MadhanSaiKrishna/AM-Modulator-Demodulator/README.md

# AM-Modulator-Demodulator
EW2 Project 2: DSB-SC Amplitude Modulator &amp; Demodulator
