MadhanSaiKrishna/AM-Modulator-Demodulator/Report/main.pdf

# Design, Implementation, and Analysis of an AM Modulator and Demodulator

## Electronic Workshop 2 - Project 2

Chamarthy Madhan Sai Krishna
Electronics & Communication Engineering IIIT Hyderabad
chamarthymadhan.k@students.iiit.ac.in 2023102030

Sajiv Singh
Electronics & Communication Engineering IIIT Hyderabad
sajiv.singh@research.iiit.ac.in 2023112003

Abstract—The project focuses on the design, implementation and analysis of a Double Sideband Suppressed Carrier (DSB-SC) Amplitude Modulation(AM) modulator and demodulator circuit prototype.
The main goal was to modulate the carrier signal, generated by the Local Oscillator (LO), using the modulating signal from the DSO, and to successfully recover the original signal. Through practical implementation, the project demonstrates the fundamental concepts of Communication Theory. The circuit helps in understanding how information can be encoded and transmitted over a carrier signal using AM techniques.
I. TO-DO:
- Improvise the photos of the spectrums - conventional AM and DSB-SC AM
- add github link, youtube video link
- add calculations, simulations, outputs,

II. INTRODUCTION
A. Background of Amplitude Modulation
Amplitude Modulation (AM) is a modulation technique where the amplitude (signal strength) of a carrier wave is varied in proportion to the message signal (e.g., audio). It’s commonly used in electronic communication for transmitting messages via radio waves. In AM, carrier signal’s amplitude, A(t), changes according to the message signal. This message signal defines the envelope of the transmitted waveform. In the frequency domain, AM produces a signal with power concentrated at the carrier frequency and two adjacent sidebands. Types of Amplitude Modulation:
- Double-Sideband Amplitude Modulation (DSB-AM): The standard AM method generates sidebands on both sides of the carrier frequency. These sidebands contain the frequency components of the modulating signal and are symmetrically placed around the carrier frequency.
- Single-Sideband Modulation (SSB): Uses bandpass filters to eliminate one sideband and possibly the carrier, improving power efficiency and bandwidth utilization.
- Quadrature Amplitude Modulation (QAM): A more complex form of Amplitude modulation is often used with digital data to enable more efficient use of bandwidth.
- Double-Sideband Suppressed Carrier (DSB-SC): This technique removes the carrier signal, transmitting only the upper and lower sidebands. It improves power efficiency but requires coherent detection at the receiver.
- Vestigial Sideband Modulation (VSB): VSB retains part of one sideband while suppressing the rest of the unwanted sideband. This method helps reduce the bandwidth required for transmission, offering a more efficient use of spectrum compared to standard AM, while still allowing for accurate signal recovery at the receiver.
- Pulse Amplitude Modulation (PAM): PAM varies the amplitude of pulses rather than a continuous wave. It is used in digital communication systems as an intermediate step before converting signals to binary formats.
B. Objectives

Following are the primary objectives of this project:
1) To design and implement a Double Sideband Suppressed Carrier (DSB-SC) Amplitude Modulation (AM) modulator circuit capable of encoding a modulating signal onto a carrier signal generated by a Local Oscillator (LO).
2) To design and implement a corresponding demodulator circuit that can successfully recover the original modulating signal from the received DSB-SC AM signal.
3) To analyze the performance of the implemented modulator and demodulator circuits through practical experimentation, demonstrating the principles of amplitude modulation in communication systems.

III. THEORETICAL BACKGROUND OF AM

Modulation: In conventional AM, we add a large carrier component to a DSB-SC signal, so that the passband transmitted signal is of the form:

uAM(t) = Am(t) cos(2πfct) + Ac cos(2πfct)

Taking the Fourier transform, we have

UAM(f) = A
2

(M(f − fc) + M(f + fc)) +


Fig. 1. Spectrum of Conventional AM


Fig. 2. Spectrum of DSB-SC AM

Ac
2

(δ(f − fc) + δ(f + fc))

which means that, in addition to the USB and LSB due to the message modulation, we also have impulses at ±fc due to the unmodulated carrier.
The key concept behind conventional AM is that, by making Ac large enough, the message can be demodulated using a simple envelope detector. Large Ac corresponds to expending transmitter power on sending an unmodulated carrier which carries no message information, in order to simplify the receiver. This tradeoff makes sense in a broadcast context, where one powerful transmitter may be sending information to a large number of low-cost receivers, and is the design approach that has been adopted for broadcast AM radio. The key issue with conventional AM is its inefficiency in terms of power utilization. This led to the development of DSB-SC modulation which addresses these issues by suppressing the carrier and improving the power efficiency.

uDSB(t) = Am(t) cos(2πfct)

Taking Fourier transforms, we have

UDSB(f) = A
2

(M(f − fc) + M(f + fc))

Demodulation:

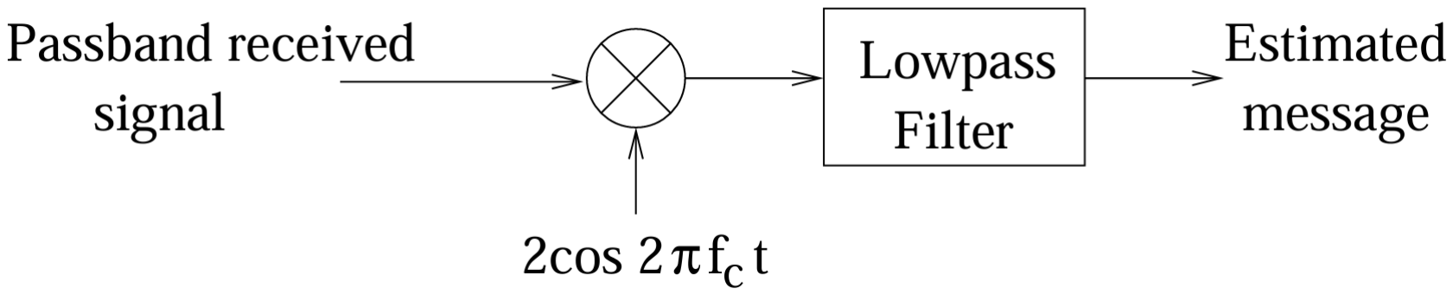
[picture p29: figure]

Fig. 3. Coherent Demodulation of AM

Multiply the received signal with the cosine of the carrier, and pass it through a low-pass filter. Ignoring noise, the received signal is given by

yp(t) = Am(t) cos(2πfct + θr)

where θr is the phase of the received carrier relative to the local copy of the carrier produced by the receiver’s local oscillator (LO), and A is the received amplitude, taking into account the propagation channel from the transmitter to the receiver. In order for this demodulator to work well, we must have θr as close to zero as possible; that is, the carrier produced by the LO must be coherent with the received carrier. The effect of phase mismatch:

2yp(t) cos(2πfct) = Am(t) cos(2πfct + θr) cos(2πfct)

= Am(t) cos θr + Am(t) cos(4πfct + θr)

We recognize the second term on the right-hand side as being a passband signal at 2fc (since it is a baseband message multiplied by a carrier whose frequency exceeds the message bandwidth). It is therefore rejected by the low-pass filter. The first term is a baseband signal proportional to the message, which appears unchanged at the output of the LPF (except possibly for scaling), as long as the LPF response has been designed to be flat over the message bandwidth. The output of the demodulator is therefore given by

mˆ (t) = Am(t) cos θr

The demodulator output is proportional to the message, which is what we want, but the proportionality constant varies with the phase of the received carrier relative to the LO. In particular, the signal gets significantly attenuated as the phase mismatch increases, and gets completely wiped out for θr =

π
2
Note that, if the carrier frequency of the LO is not synchronized with that of the received carrier (say with frequency offset ∆f), then θr(t) = 2π∆f t + ϕ is a time-varying phase that takes all values in [0, 2π), which leads to time-varying signal degradation in amplitude, as well as unwanted sign changes. Thus, for coherent demodulation to be successful, we must drive ∆f to zero, and make ϕ as small as possible; that is, we must synchronize to the received carrier.

IV. CIRCUIT DESIGN & IMPLEMENTATION

A. Local Oscillator
Ref. from last year AEC project


Fig. 4. Full Circuit


Fig. 5. Simulation output of the Oscillator

B. Modulator
Ref. from last year mixer
C. Demodulator
mixer + LPF
V. EXPERIMENTAL SETUP & METHODOLOGY

VI. RESULTS & PERFORMANCE METRICS
1) Detectability: , i.e., the quality of the demodulated signal for a given amount of channel attenuation and receiver noise.
2) Bandwidth efficiency: , i.e., the bandwidth occupied by the modulated carrier for a given information rate in the baseband signal. This aspect plays a critical role in today’s systems because the available spectrum is limited.

VII. CONCLUSION
The project successfully demonstrated the design, implementation, and analysis of a Double Sideband Suppressed Carrier (DSB-SC) Amplitude Modulation (AM) modulator and demodulator circuit prototype. The experimental results confirmed the effectiveness of the DSB-SC technique in modulating and demodulating signals, showcasing its potential for efficient communication systems.The project also highlighted the importance of coherent detection and the challenges associated with phase synchronization in demodulation.
Github: Repository Link (https://github.com/MadhanSaiKrishna/AM-Modulator-Demodulator)
Youtube: Video Link

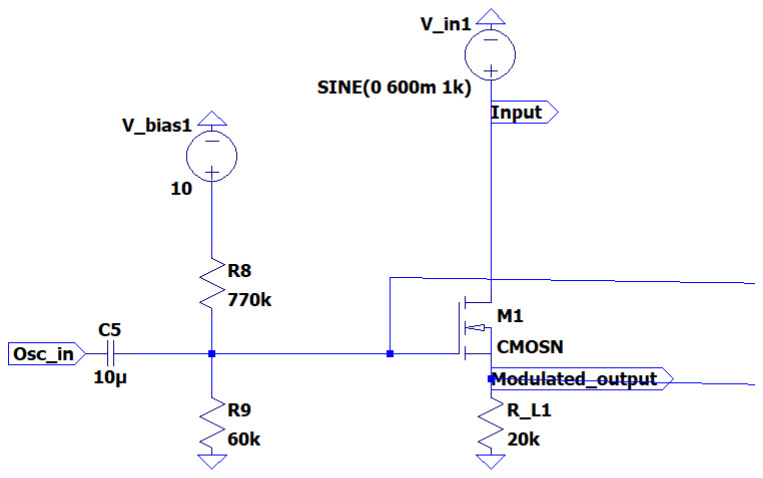
[picture p30: figure]

Fig. 6. Circuit diagram of the modulator

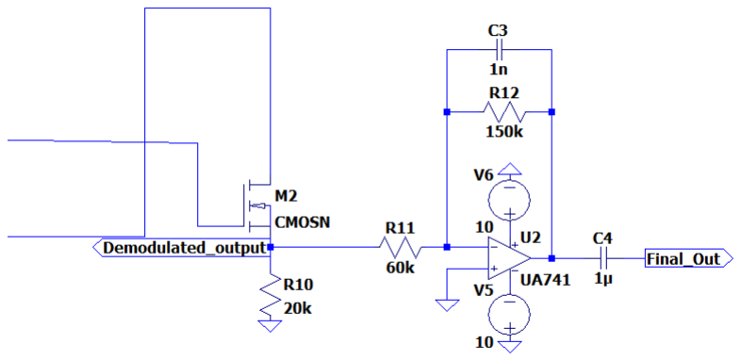
[picture p31: figure]

Fig. 7. Circuit diagram of the demodulator


Fig. 8. FFT of the output of the oscillator (Simulation)

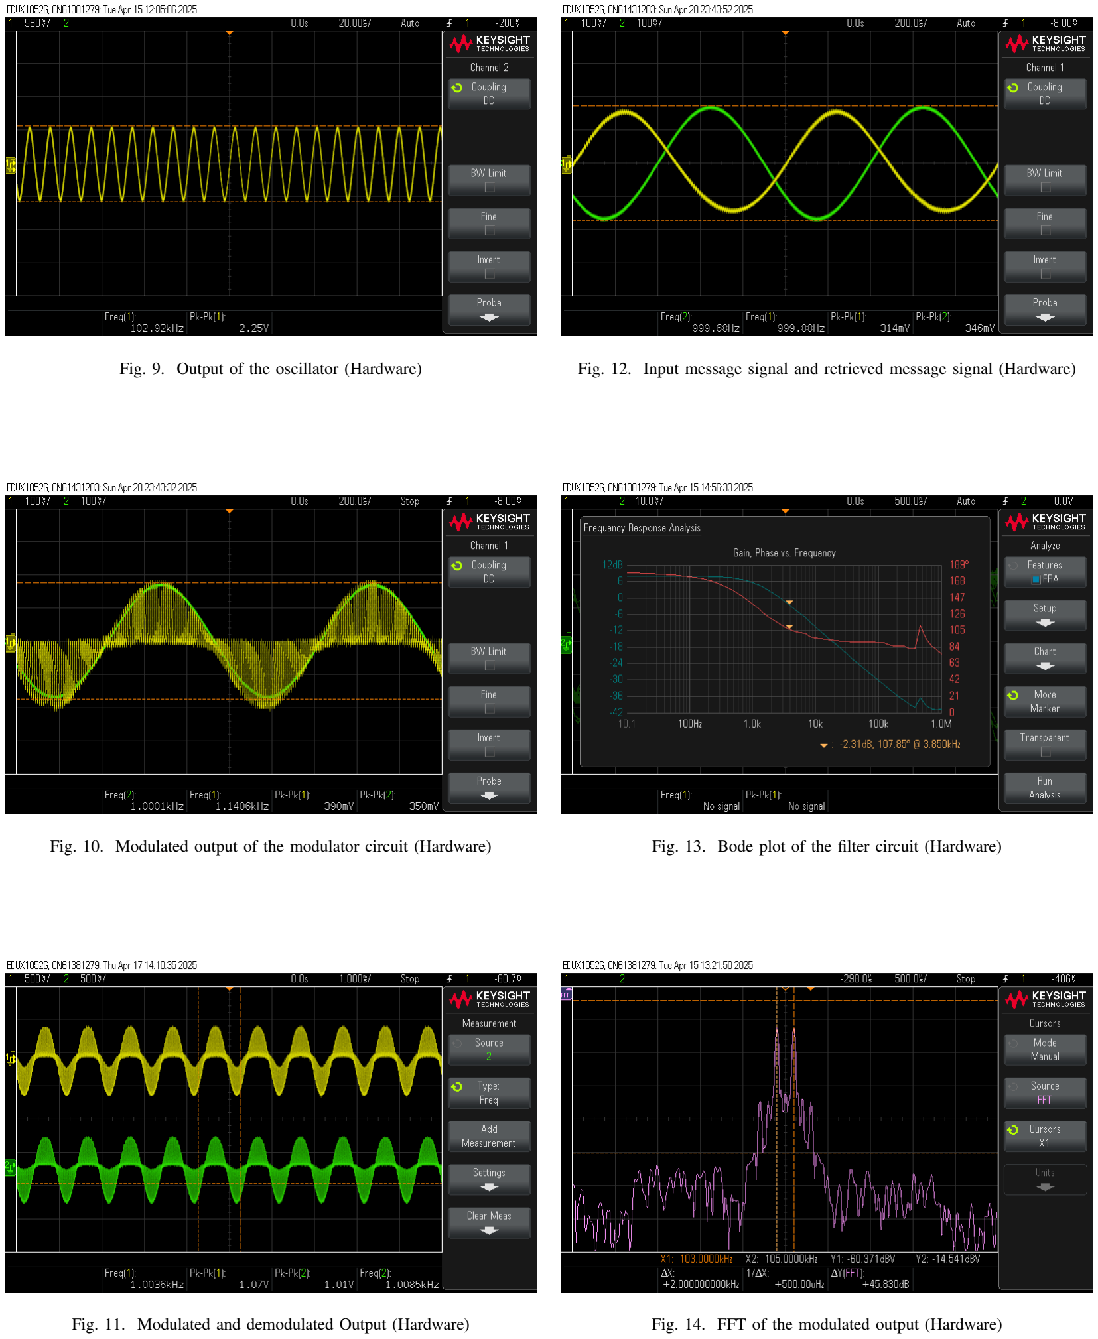
[picture p32: page 4]

Fig. 9. Output of the oscillator (Hardware)

Fig. 10. Modulated output of the modulator circuit (Hardware)

Fig. 11. Modulated and demodulated Output (Hardware)

Fig. 12. Input message signal and retrieved message signal (Hardware)

Fig. 13. Bode plot of the filter circuit (Hardware)

Fig. 14. FFT of the modulated output (Hardware)

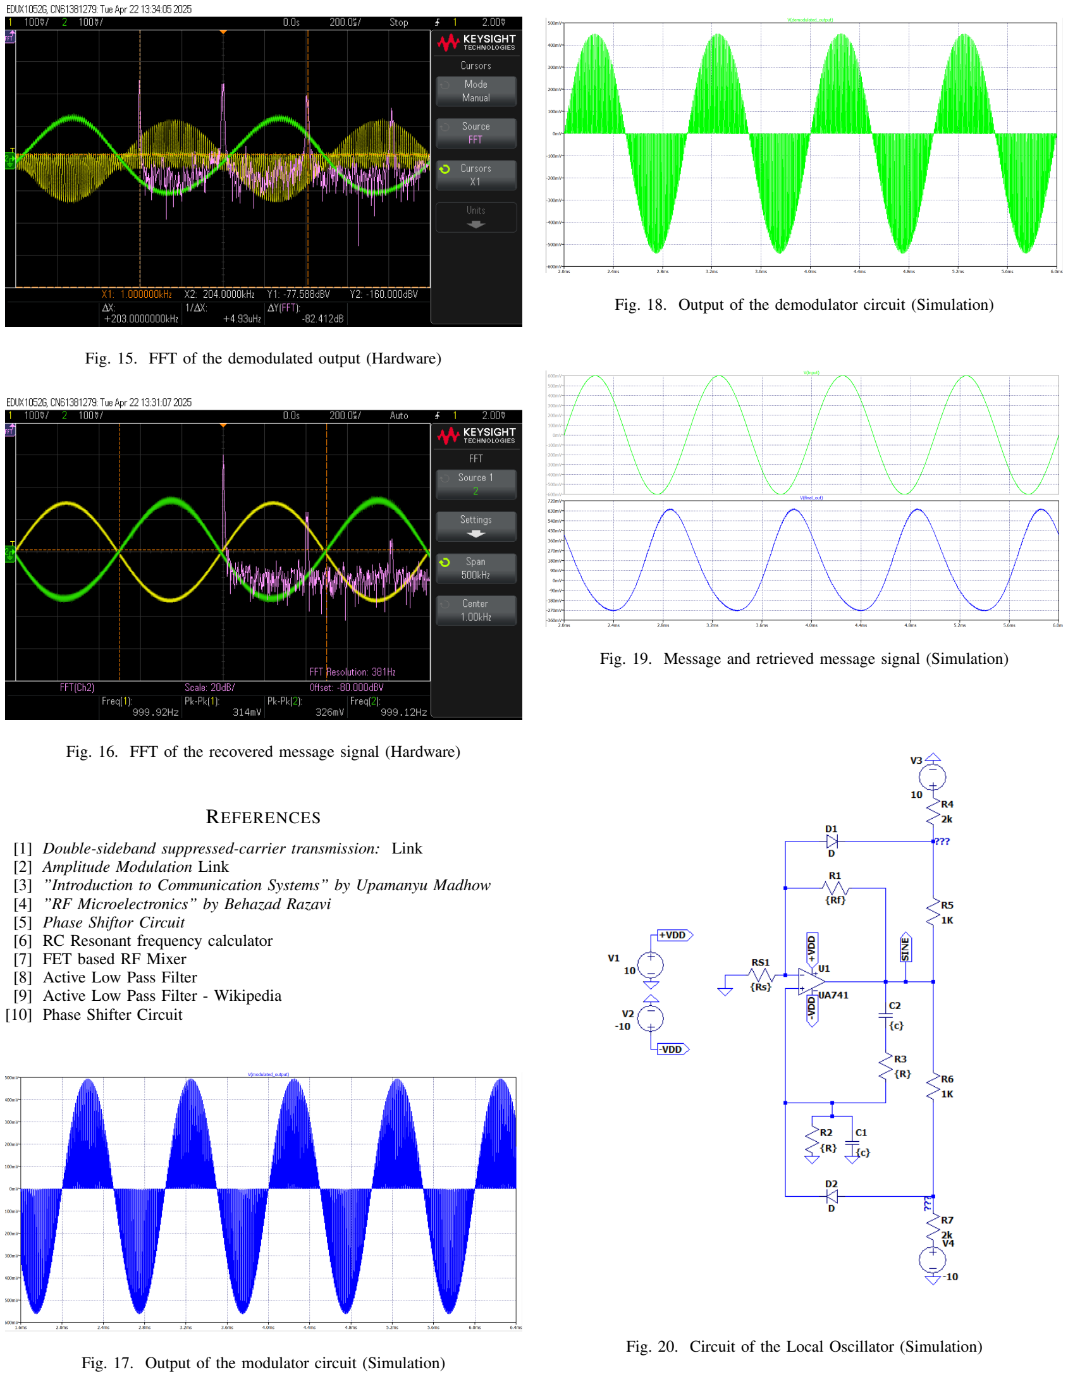
[picture p33: page 5]

Fig. 15. FFT of the demodulated output (Hardware)

Fig. 16. FFT of the recovered message signal (Hardware)

REFERENCES

[1] Double-sideband suppressed-carrier transmission: Link (https://en.wikipedia.org/wiki/Double-sideband_suppressed-carrier_transmission)
[2] Amplitude Modulation Link (https://en.wikipedia.org/wiki/Amplitude_modulation)
[3] ”Introduction to Communication Systems” by Upamanyu Madhow
[4] ”RF Microelectronics” by Behazad Razavi
[5] Phase Shiftor Circuit (https://vesit.ves.ac.in/RC_phase_shift/theory)
[6] RC Resonant frequency calculator (https://www.omnicalculator.com/physics/rc-circuit)
[7] FET based RF Mixer (https://www.electronics-notes.com/articles/radio/rf-mixer/fet-rf-mixer.php)
[8] Active Low Pass Filter (https://www.electronics-tutorials.ws/filter/filter_5.html)
[9] Active Low Pass Filter - Wikipedia (https://en.wikipedia.org/wiki/Low-pass_filter)
[10] Phase Shifter Circuit (https://wiraelectrical.com/phase-shifter-formula-and-operation/)

Fig. 17. Output of the modulator circuit (Simulation)

Fig. 18. Output of the demodulator circuit (Simulation)

Fig. 19. Message and retrieved message signal (Simulation)

Fig. 20. Circuit of the Local Oscillator (Simulation)

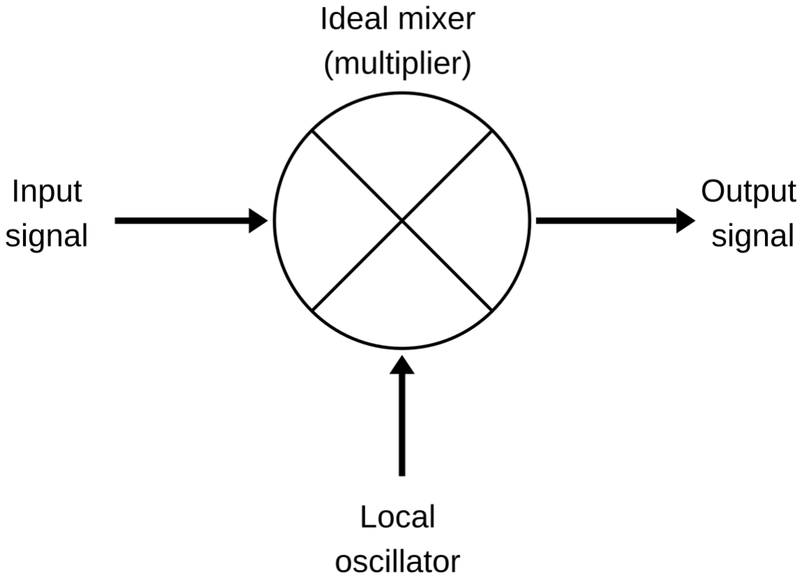
[picture p34: figure]

Fig. 21. Mixer
