MadhanSaiKrishna/AM-Modulator-Demodulator/DSO Results/15th April/scope_1.png

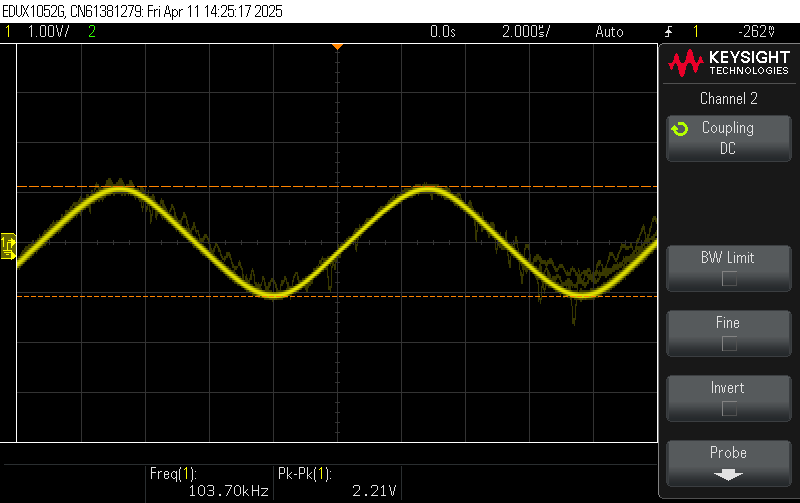
DSO Results/15th April/scope_1.png
