MadhanSaiKrishna/AM-Modulator-Demodulator/DSO Results/15th April/scope_3.png

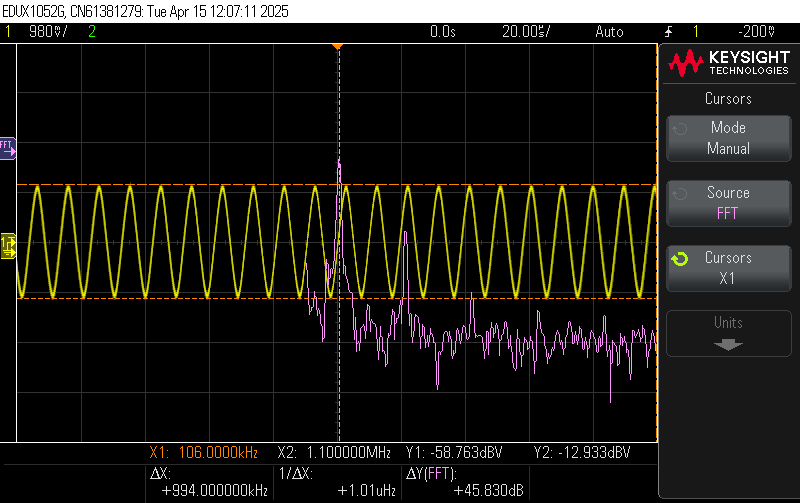
DSO Results/15th April/scope_3.png
