MadhanSaiKrishna/AM-Modulator-Demodulator/DSO Results/15th April/scope_4.png

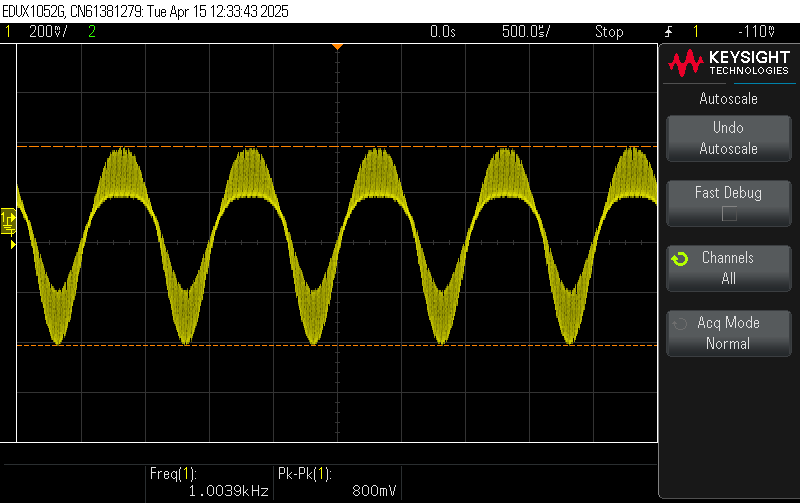
DSO Results/15th April/scope_4.png
