MadhanSaiKrishna/AM-Modulator-Demodulator/DSO Results/15th April/scope_5.png

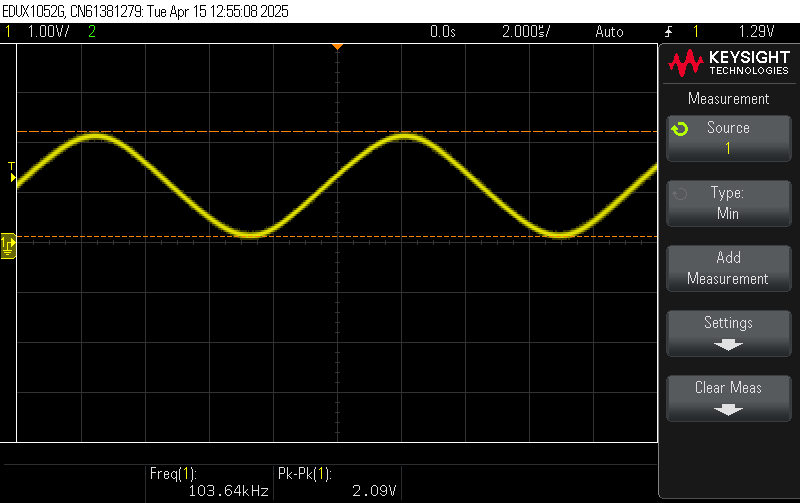
DSO Results/15th April/scope_5.png
