MadhanSaiKrishna/AM-Modulator-Demodulator/DSO Results/15th April/scope_6.png

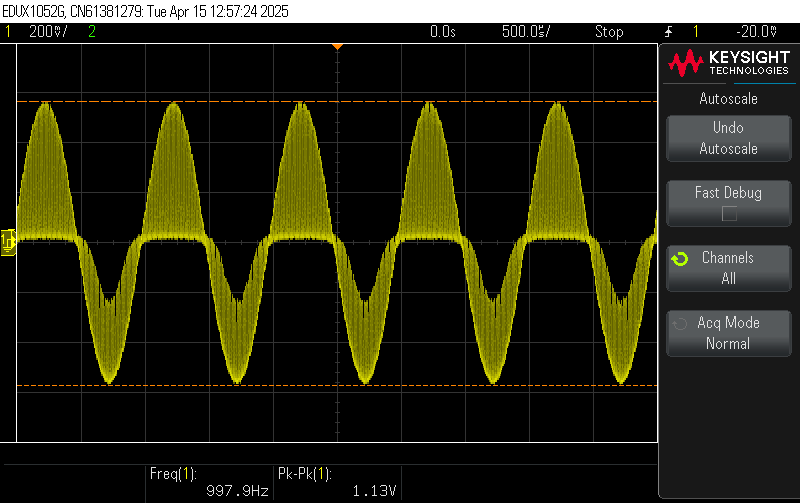
DSO Results/15th April/scope_6.png
