MadhanSaiKrishna/AM-Modulator-Demodulator/DSO Results/15th April/scope_7.png

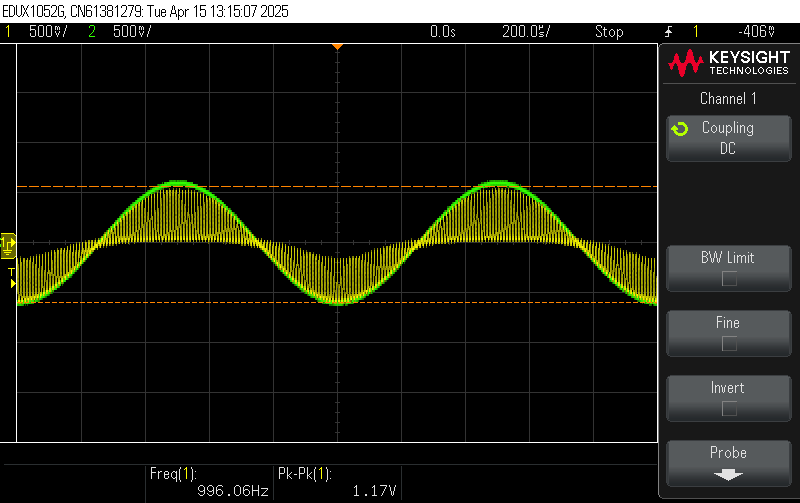
DSO Results/15th April/scope_7.png
