MadhanSaiKrishna/AM-Modulator-Demodulator/DSO Results/15th April/scope_8.png

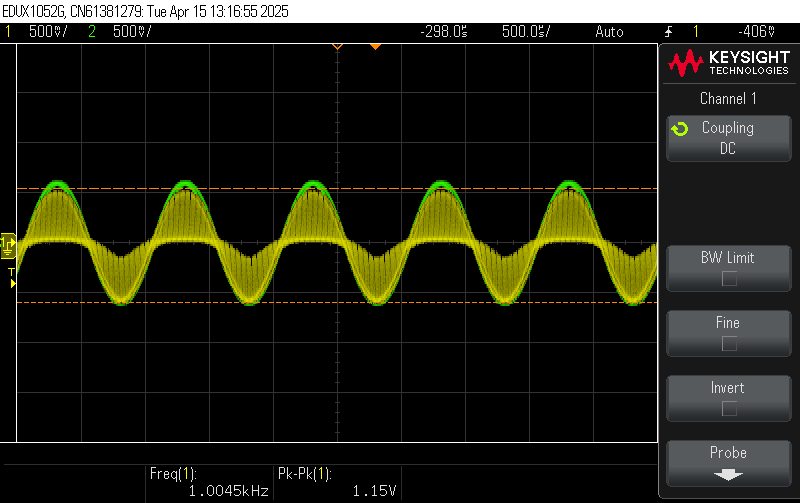
DSO Results/15th April/scope_8.png
