MadhanSaiKrishna/AM-Modulator-Demodulator/DSO Results/15th April/scope_9.png

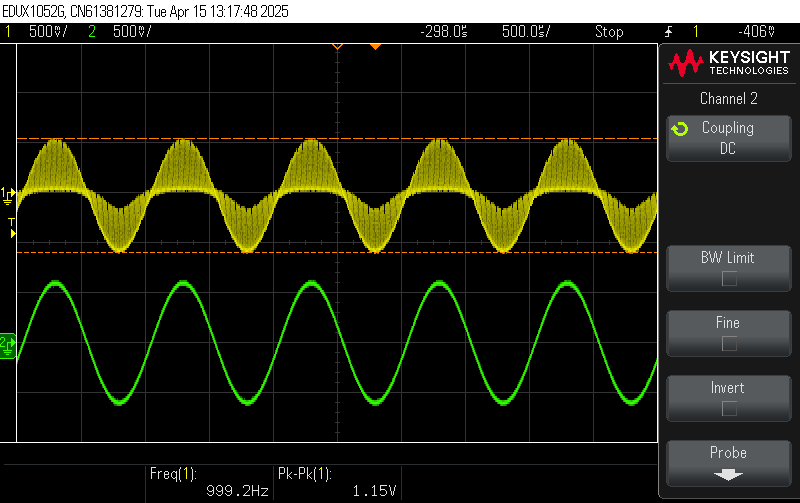
DSO Results/15th April/scope_9.png
