MadhanSaiKrishna/AM-Modulator-Demodulator/DSO Results/15th April/scope_11.png

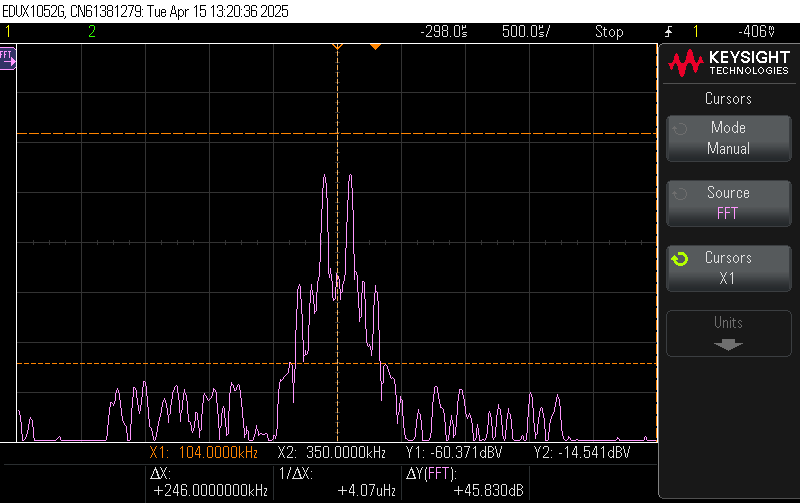
DSO Results/15th April/scope_11.png
