MadhanSaiKrishna/AM-Modulator-Demodulator/DSO Results/17th April/scope_16.png

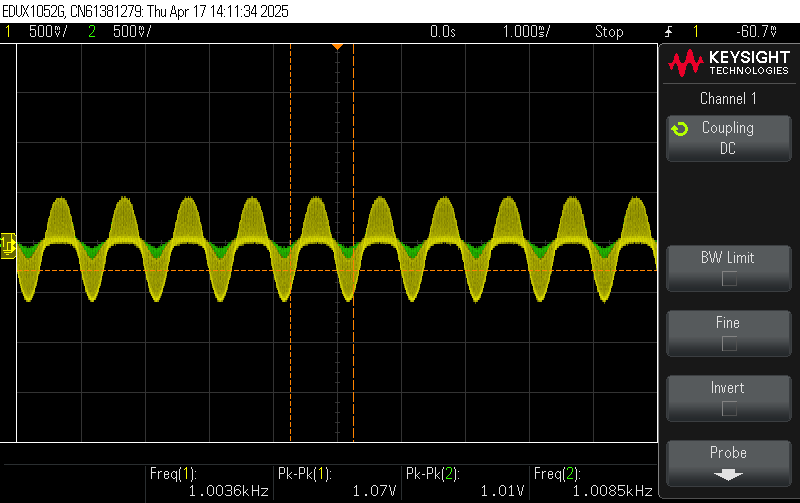
DSO Results/17th April/scope_16.png
