MadhanSaiKrishna/AM-Modulator-Demodulator/DSO Results/17th April/scope_17.png

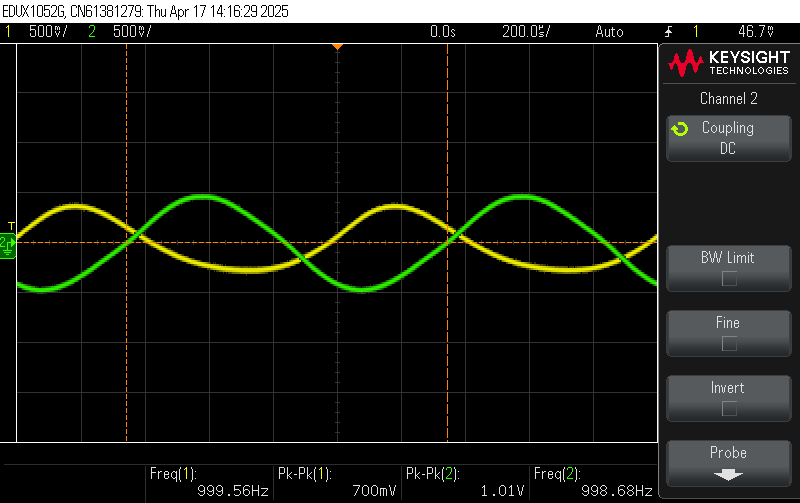
DSO Results/17th April/scope_17.png
