MadhanSaiKrishna/AM-Modulator-Demodulator/DSO Results/17th April/scope_18.png

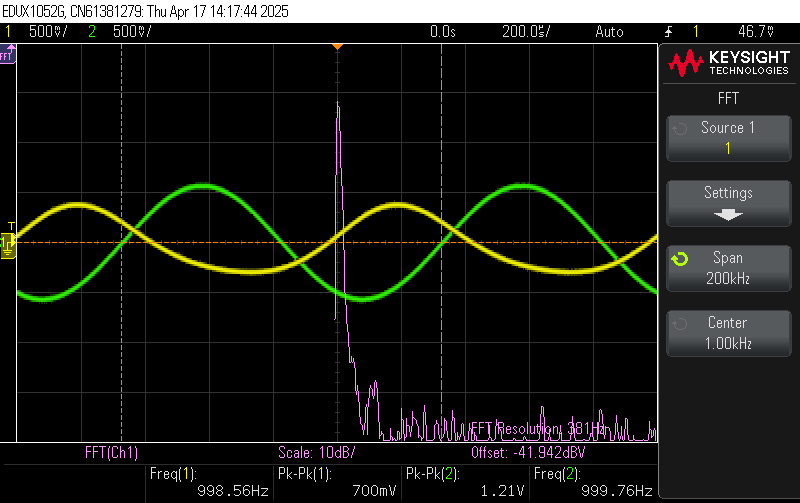
DSO Results/17th April/scope_18.png
