MadhanSaiKrishna/AM-Modulator-Demodulator/DSO Results/17th April/scope_19.png

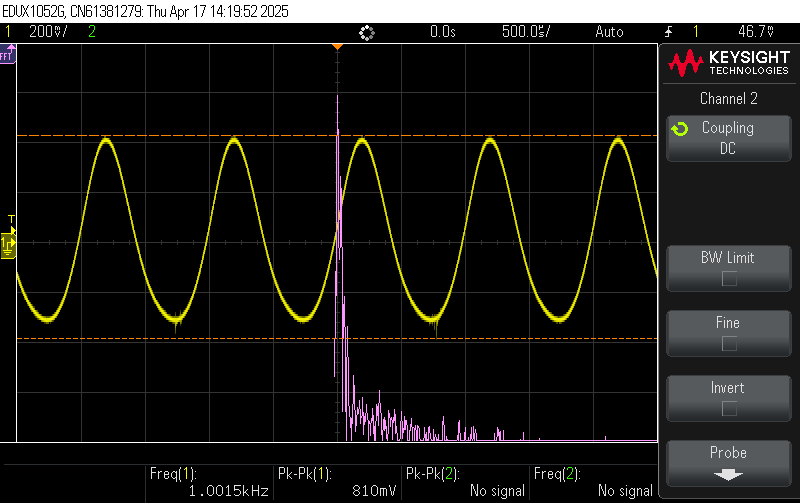
DSO Results/17th April/scope_19.png
