MadhanSaiKrishna/AM-Modulator-Demodulator/DSO Results/17th April/scope_20.png

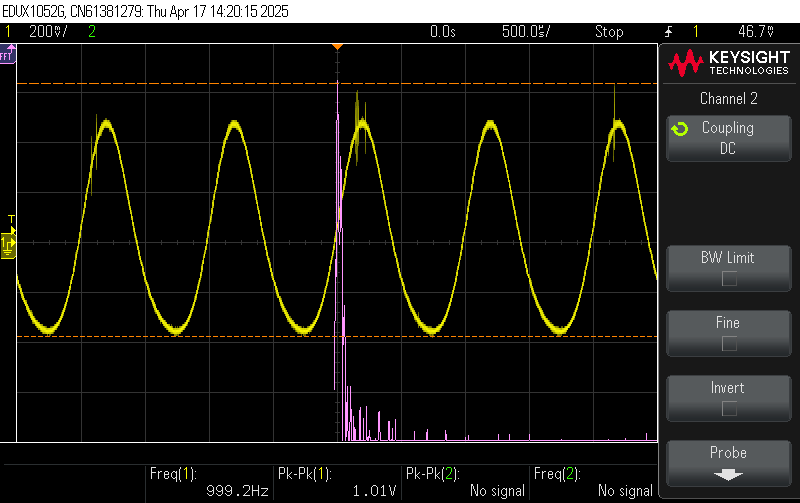
DSO Results/17th April/scope_20.png
