MadhanSaiKrishna/AM-Modulator-Demodulator/DSO Results/20th April/scope_21.png

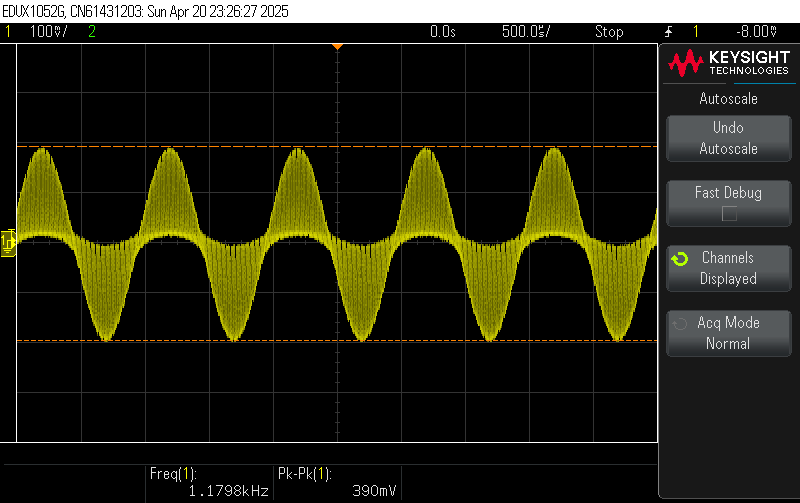
DSO Results/20th April/scope_21.png
