MadhanSaiKrishna/AM-Modulator-Demodulator/DSO Results/20th April/scope_22.png

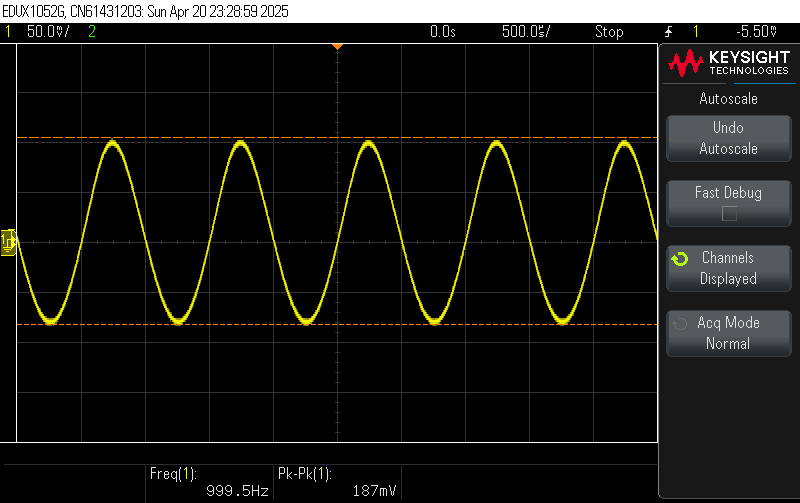
DSO Results/20th April/scope_22.png
