MadhanSaiKrishna/AM-Modulator-Demodulator/DSO Results/20th April/scope_23.png

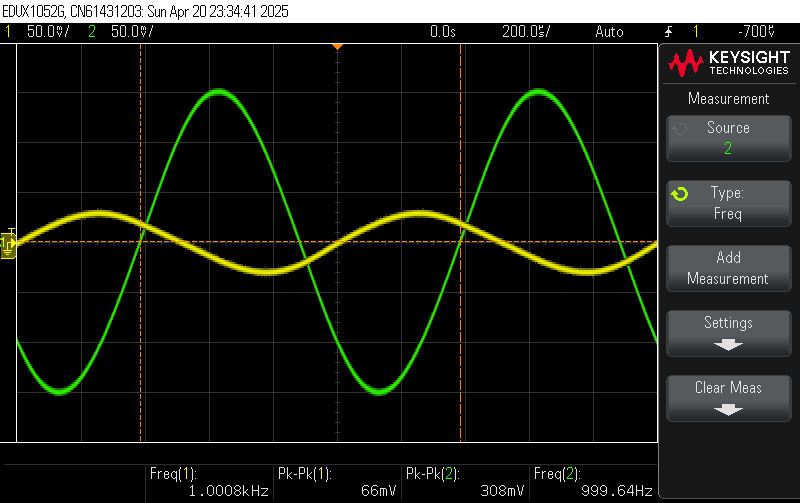
DSO Results/20th April/scope_23.png
