MadhanSaiKrishna/AM-Modulator-Demodulator/DSO Results/20th April/scope_24.png

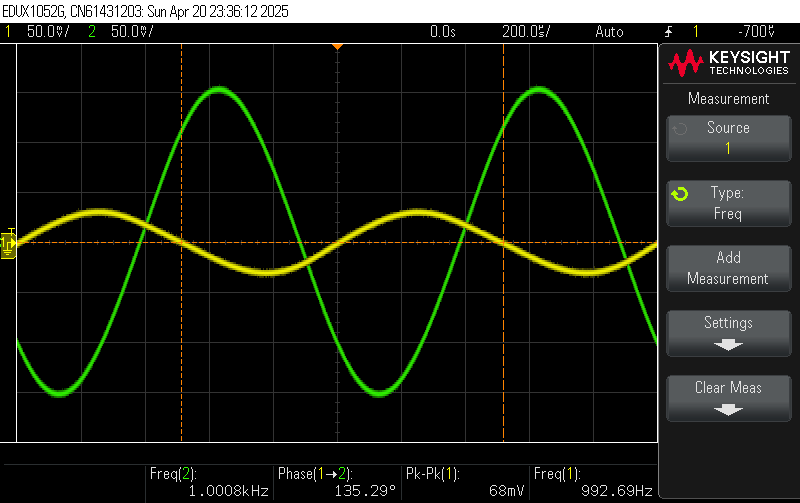
DSO Results/20th April/scope_24.png
