MadhanSaiKrishna/AM-Modulator-Demodulator/DSO Results/20th April/scope_26.png

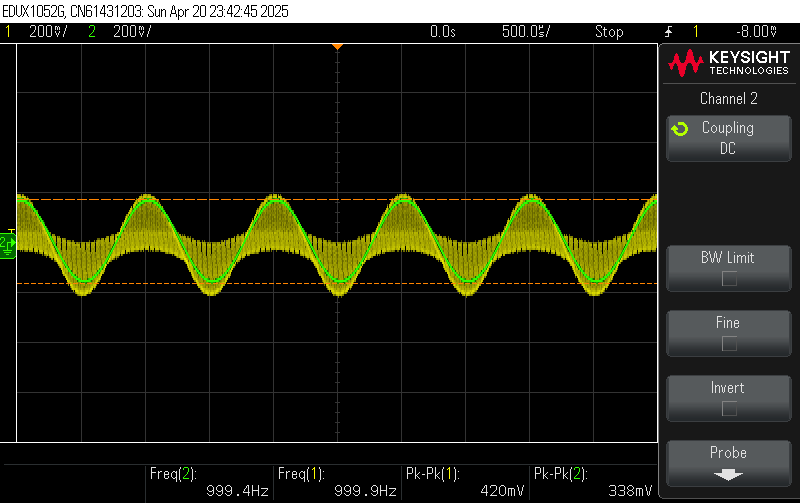
DSO Results/20th April/scope_26.png
