MadhanSaiKrishna/AM-Modulator-Demodulator/DSO Results/20th April/scope_30.png

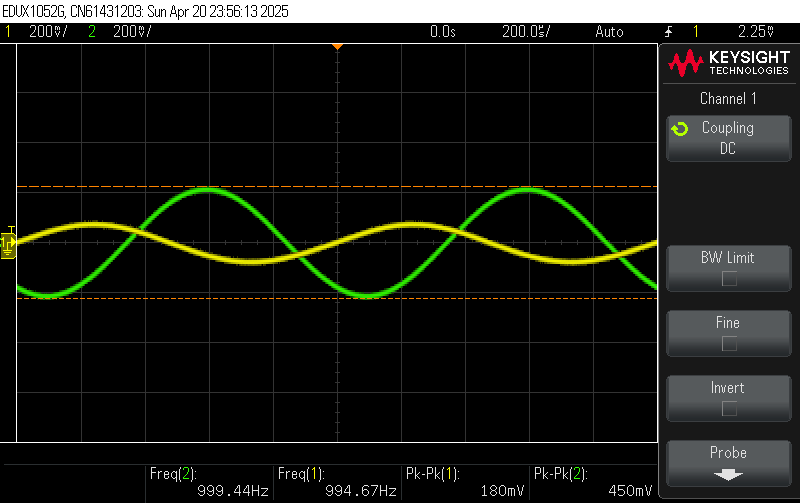
DSO Results/20th April/scope_30.png
