MadhanSaiKrishna/AM-Modulator-Demodulator/DSO Results/20th April/scope_31.png

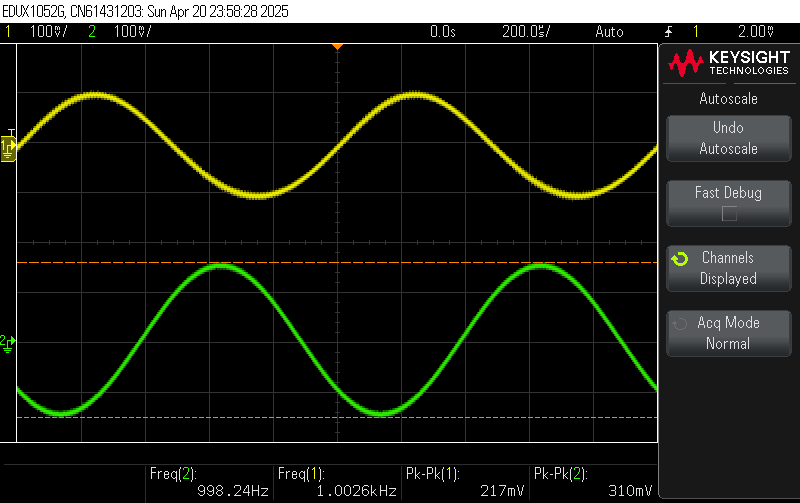
DSO Results/20th April/scope_31.png
