MadhanSaiKrishna/AM-Modulator-Demodulator/DSO Results/20th April/scope_32.png

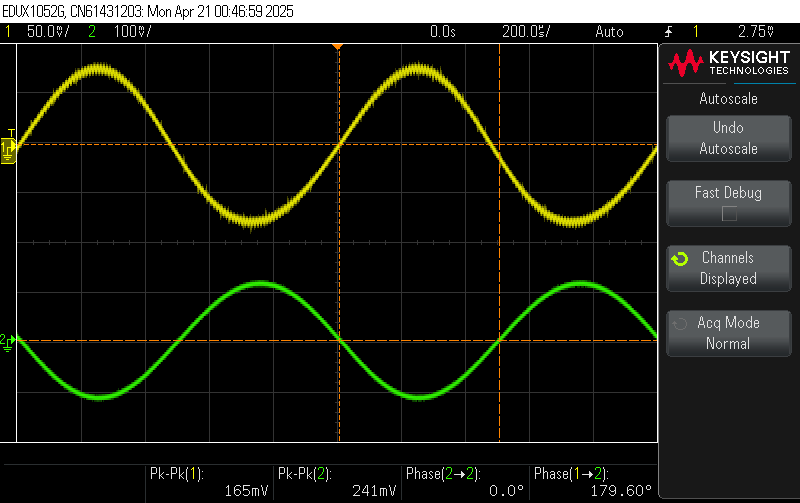
DSO Results/20th April/scope_32.png
