MadhanSaiKrishna/AM-Modulator-Demodulator/DSO Results/22nd April/scope_36.png

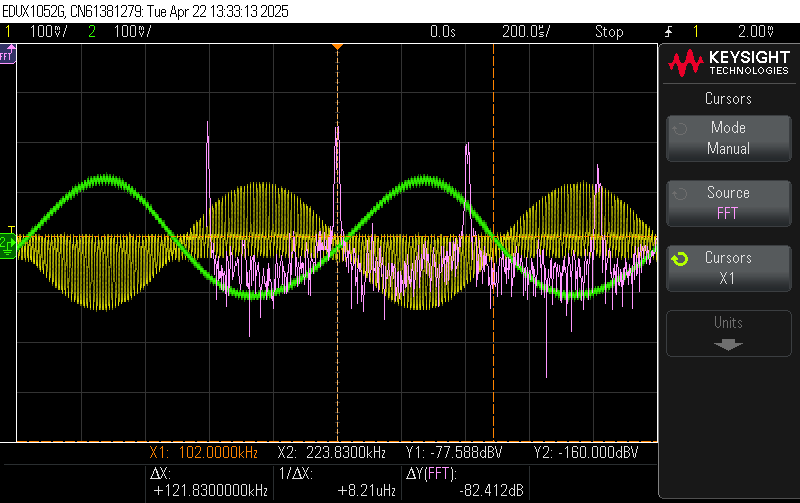
DSO Results/22nd April/scope_36.png
