MadhanSaiKrishna/AM-Modulator-Demodulator/DSO Results/25th March/scope_0.png

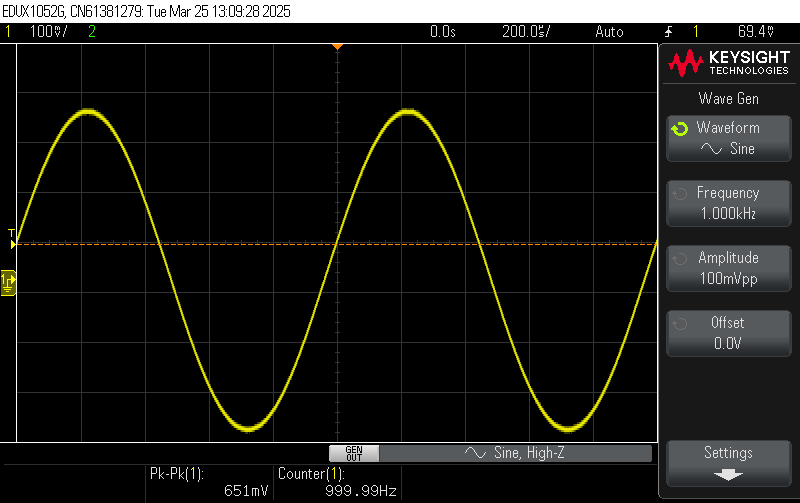
DSO Results/25th March/scope_0.png
