MadhanSaiKrishna/AM-Modulator-Demodulator/DSO Results/25th March/scope_1.png

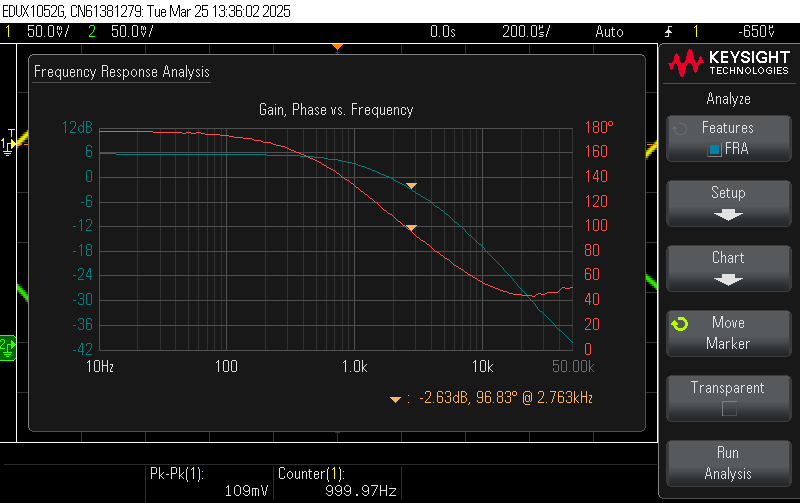
DSO Results/25th March/scope_1.png
