MadhanSaiKrishna/AM-Modulator-Demodulator/DSO Results/25th March/scope_2.png

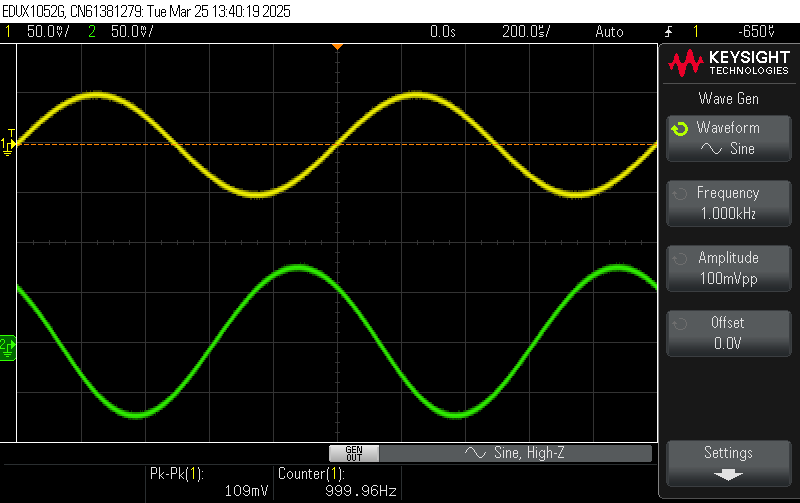
DSO Results/25th March/scope_2.png
