MadhanSaiKrishna/AM-Modulator-Demodulator/Updated_circuit.asc

C1: cap; {c}
C2: cap; {c}
C3: cap; 1n
C4: cap; 1µ
C5: cap; 10µ
D1: diode
D2: diode
M1: nmos4; CMOSN; l={2*LAMBDA} w={width_N} ad={5*width_ N*LAMBDA} as={5*width_ N*LAMBDA} pd={10*LAMBDA+2*width_N} ps={10*LAMBDA+2*width_N}
M2: nmos4; CMOSN; l={2*LAMBDA} w={width_N} ad={5*width_ N*LAMBDA} as={5*width_ N*LAMBDA} pd={10*LAMBDA+2*width_N} ps={10*LAMBDA+2*width_N}
R1: res; {Rf}
R2: res; {R}
R3: res; {R}
R4: res; 2k
R5: res; 1K
R6: res; 1K
R7: res; 2k
R8: res; 770k
R9: res; 45k
R10: res; 20k
R11: res; 60k
R12: res; 150k
R_L1: res; 20k
RS1: res; {Rs}
U1: opamp2; UA741
U2: opamp2; UA741
V1: voltage; 10
V2: voltage; -10
V3: voltage; 10
V4: voltage; -10
V5: voltage; 10
V6: voltage; 10
V_bias1: voltage; 10
V_in1: voltage; SINE(0 600m 1k)
Named nets: 0, +VDD, -VDD, SINE, Input, Final_Out, Demodulated_output, Modulated_output
.include TSMC_180nm.txt
.tran 10m
.param R=12k c=35p
.param Rf=50k Rs=10k
.include UA741.301
.param width_N=1u
.param LAMBDA=0.09u
