MadhanSaiKrishna/AM-Modulator-Demodulator/oscillator.asc

C1: cap; {c}
C2: cap; {c}
D1: diode
D2: diode
R1: res; {Rf}
R2: res; {R}
R3: res; {R}
R4: res; 2k
R5: res; 1K
R6: res; 1K
R7: res; 2k
RS1: res; {Rs}
U1: opamp2; UA741
V1: voltage; 10
V2: voltage; -10
V3: voltage; 10
V4: voltage; -10
Named nets: 0, +VDD, -VDD, SINE
.include TSMC_180nm.txt
.tran 5m
.param R=12k c=45p
.param Rf=50k Rs=10k
.include UA741.301
