MadhanSaiKrishna/AM-Modulator-Demodulator/Initial_Circuit.asc

C1: cap; 1µ
C2: cap; 1µ
C3: cap; 47n
C4: cap; 1n
C5: cap; 1µ
C6: cap; 47n
C_c1: cap; 10µ
L1: ind; 12µ
L2: ind; 12µ
M1: nmos4; CMOSN; l={2*LAMBDA} w={width_N} ad={5*width_ N*LAMBDA} as={5*width_ N*LAMBDA} pd={10*LAMBDA+2*width_N} ps={10*LAMBDA+2*width_N}
M2: nmos4; CMOSN; l={2*LAMBDA} w={width_N} ad={5*width_ N*LAMBDA} as={5*width_ N*LAMBDA} pd={10*LAMBDA+2*width_N} ps={10*LAMBDA+2*width_N}
Q1: npn; BC547B
R1: res; 220k
R2: res; 20k
R3: res; 770k
R4: res; 230k
R5: res; 20k
R6: res; 3k
R7: res; 60k
R8: res; 150k
R_L1: res; 20k
Rc1: res; 22k
U1: opamp2; UA741
V1: voltage; 10
V2: voltage; 10
V3: voltage; SINE(0 1 5k)
V_bias1: voltage; 10
V_in1: voltage; SINE(0 600m 1k)
Vcc1: voltage; 10
Named nets: 0, Input, Modulated_output, Final_Out, Demodulated_output, Ref_for_noise
.include TSMC_180nm.txt
.param width_N=1u
.param LAMBDA=0.09u
.include UA741.301
.tran 50m
