MadhanSaiKrishna/AM-Modulator-Demodulator/tank_amplifier_combined.asc

C1: cap; 1µ
C2: cap; 1µ
C3: cap; 47n
C4: cap; 47n
L1: ind; 12µ
L2: ind; 12µ
Q1: npn; BC547B
R1: res; 220k
R2: res; 20k
R3: res; 3k
Rc1: res; 22k
Vcc1: voltage; 10
Named nets: 0
.tran 50m
