MadhanSaiKrishna/AM-Modulator-Demodulator/ce_amplifier.asc

C1: cap; 1µ
C2: cap; 1µ
Q1: npn; BC547B
R1: res; 220k
R2: res; 3k
R3: res; 20k
Rc: res; 22k
V1: voltage; SINE(0 20m 1k)
Vcc: voltage; 10
Named nets: 0, Input, Output
.tran 10m
