MadhanSaiKrishna/AM-Modulator-Demodulator/mod_demod_combined.asc

C1: cap; 1n
C_c1: cap; 10µ
M1: nmos4; CMOSN; l={2*LAMBDA} w={width_N} ad={5*width_ N*LAMBDA} as={5*width_ N*LAMBDA} pd={10*LAMBDA+2*width_N} ps={10*LAMBDA+2*width_N}
M2: nmos4; CMOSN; l={2*LAMBDA} w={width_N} ad={5*width_ N*LAMBDA} as={5*width_ N*LAMBDA} pd={10*LAMBDA+2*width_N} ps={10*LAMBDA+2*width_N}
R1: res; 770k
R2: res; 230k
R3: res; 1k
R4: res; 150k
R_L1: res; 1k
V_bias1: voltage; 10
V_in1: voltage; SINE(0 600m 1k)
v_osc1: voltage; SINE(0 1 245k)
Named nets: 0
.include "TSMC_180nm.txt"
.param width_N=1u
.param LAMBDA=0.09u
