MadhanSaiKrishna/AM-Modulator-Demodulator/demodulator.asc

C1: cap; 1n
M1: nmos4; CMOSN; l={2*LAMBDA} w={width_N} ad={5*width_ N*LAMBDA} as={5*width_ N*LAMBDA} pd={10*LAMBDA+2*width_N} ps={10*LAMBDA+2*width_N}
R1: res; 1k
R2: res; 150k
Named nets: 0, Mixer_output, Gate_of_Modulator
.include "C:\\Users\\Sajiv\\Downloads\\TSMC_180nm.txt"
.param width_N=1u
.param LAMBDA=0.09u
