MadhanSaiKrishna/AM-Modulator-Demodulator/mixer.asc

C_c: cap; 10µ
M1: nmos4; CMOSN; l={2*LAMBDA} w={width_N} ad={5*width_ N*LAMBDA} as={5*width_ N*LAMBDA} pd={10*LAMBDA+2*width_N} ps={10*LAMBDA+2*width_N}
R1: res; 770k
R2: res; 230k
R_L: res; 1k
V_bias: voltage; 10
V_in: voltage; SINE(0 600m 1k)
v_osc: voltage; SINE(0 1 245k)
Named nets: 0, Output
.include "C:\\Users\\Sajiv\\Downloads\\TSMC_180nm.txt"
.param width_N=1u
.param LAMBDA=0.09u
