MadhanSaiKrishna/AM-Modulator-Demodulator/tank_circuit.asc

C1: cap; 1n
L1: ind; 220µ
L2: ind; 220µ
Named nets: 0, to_amplifier, from_amplifier
