MadhanSaiKrishna/AM-Modulator-Demodulator/(commit log)

2025-03-11 New mosfet file
2025-03-11 added full circuit
2025-03-18 minor changes to full circuit
2025-03-21 Full circuit changes
2025-03-22 full circuit oscillator noise pickup issue
2025-04-08 new oscillator, full circuit update
2025-04-15 filter, modulator done, fix demodulator integration
2025-04-17 full circuit assembly
2025-04-21 Final circuit results
